ShellAlbert/PoF_TMR/NewVersion_3Sensors_TempPowerMonitor/Schematic/PSU.png

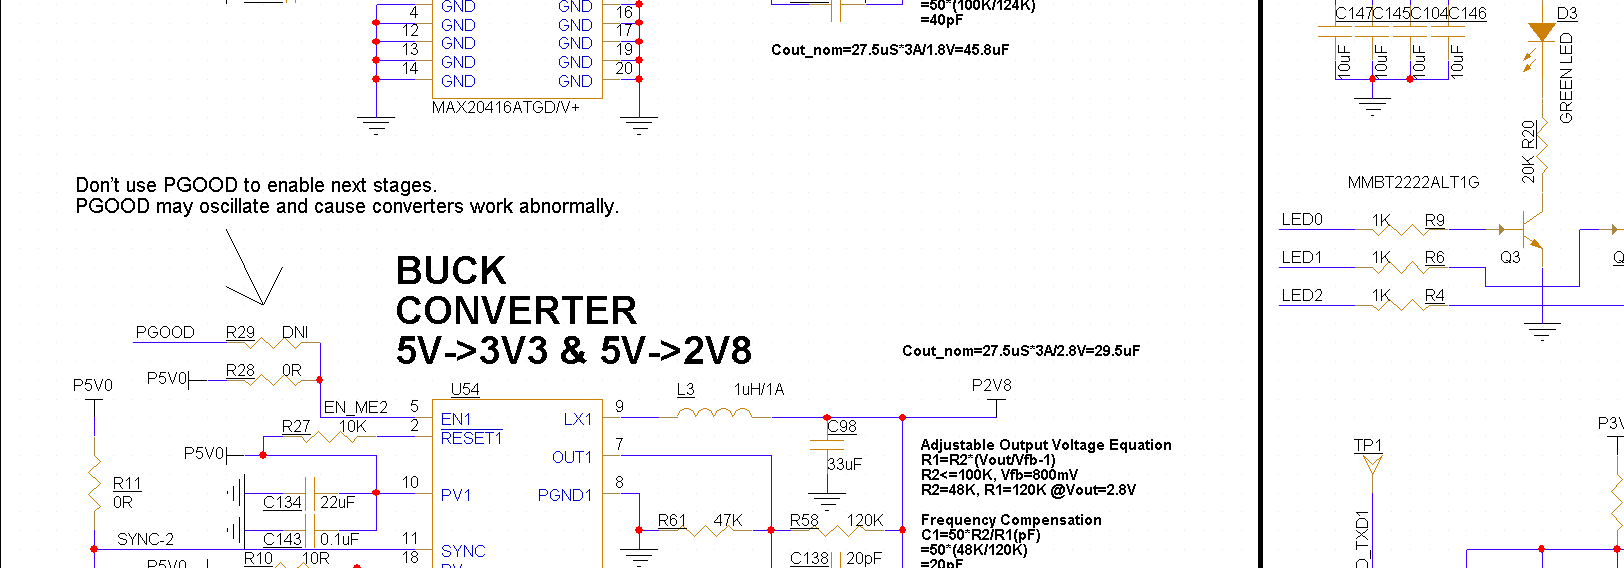
NewVersion_3Sensors_TempPowerMonitor/Schematic/PSU.png
