ShellAlbert/PoF_TMR/NewVersion_3Sensors_TempPowerMonitor/WangZhiiLiang_Handover/377886659.jpg

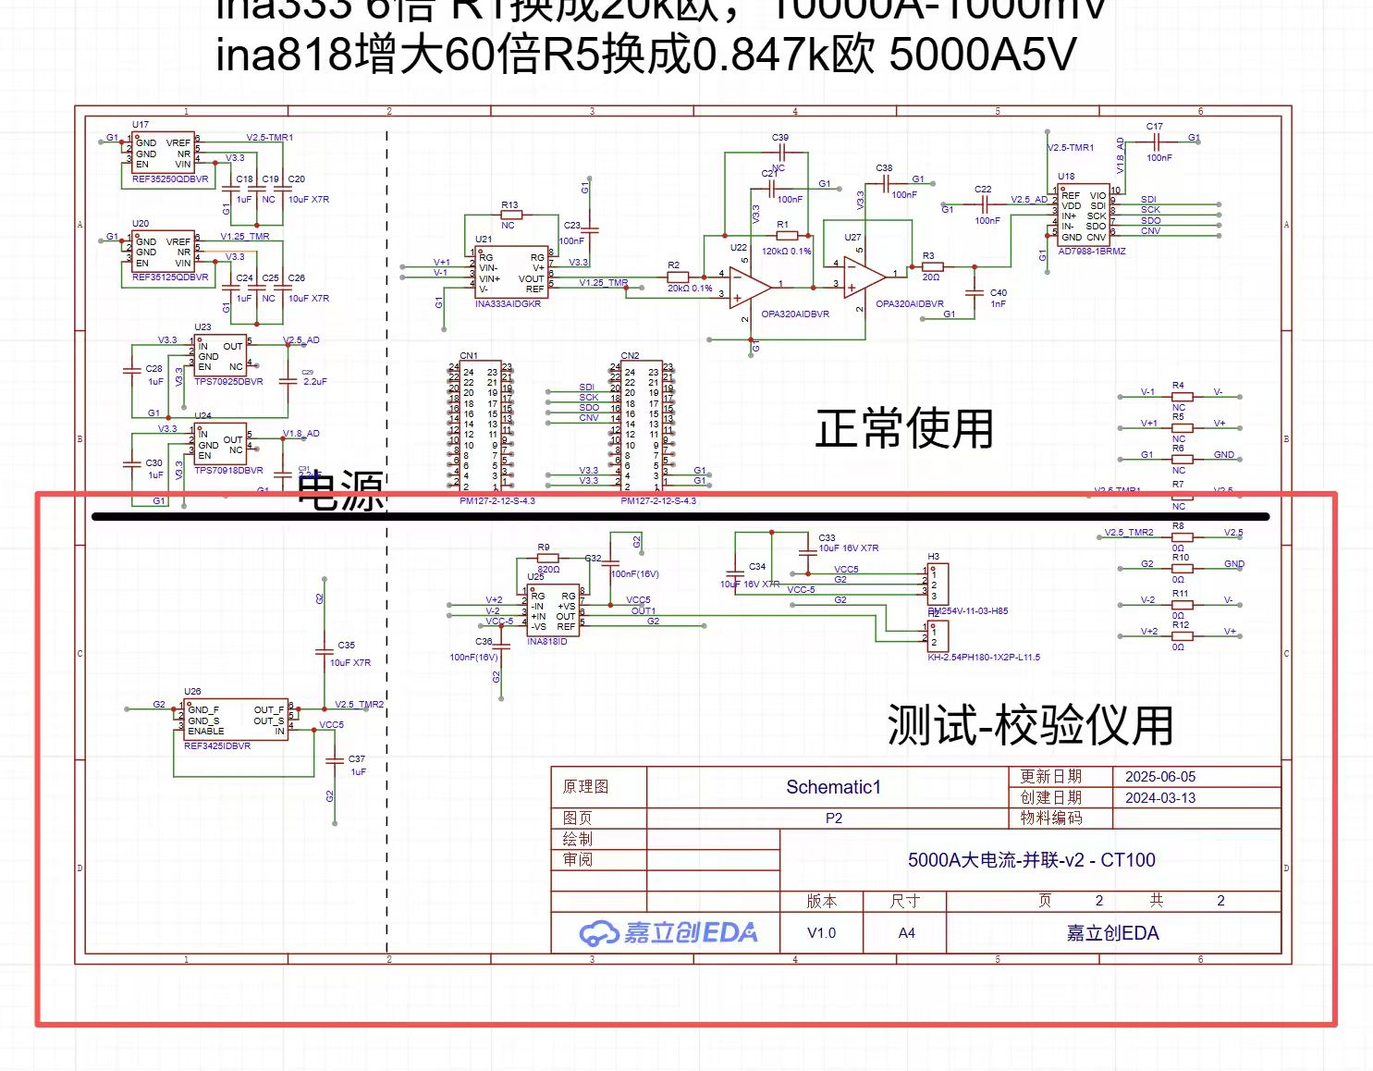
NewVersion_3Sensors_TempPowerMonitor/WangZhiiLiang_Handover/377886659.jpg
