ShellAlbert/PoF_TMR/Separated_Version_No_PowerMonitor/Fabrication/BOM_JLC_Matched.xls

型号 | 封装 | 位号 | 元件编号
22nF | C0402_SMT | C13,C15 | C1532
510 | R0402_SMT | R33 | C25123
20R | R0402_SMT | R72,R73 | C25089
CONN-1X8 | FPC-0D5-8P | J1,J4 | C262657
iCE40UP5K-SG48 | QFN-48 | U5 | C2678152
12.0MHz | SMD2520-4P | Y1 | C669073
125K | R0402_SMT | R56 | C36777
MAX20416ATGD/V+ | TQFN-24 | U3,U4 | C3188775
10uF | C0402_SMT | C1,C9,C11,C34,C37,C39,C41,C46,C49,C50,C51,C52,C53,C54,C55,C56 | C15525
HFBR-1414TZ-TX | HFBR-1414TZ-TX | D4,D5 | C33189
LTC3129EUD | QFN-16 | U6 | C580698
20K | R0402_SMT | R8,R11,R17 | C25765
47uF | C1206_SMT | C7,C8,C10,C14,C17,C19 | C403725
1N5819WT | SOD-523 | D6 | C5185918
120K | R0402_SMT | R57 | C25750
10R | R0402_SMT | R2,R4 | C25077
10nF | C0402_SMT | C47 | C15195
470K | R0402_SMT | R37,R45 | C25790
1uH/1A | L1210 | L1,L2,L3,L4 | C237284
100R | R0402_SMT | R64 | C25076
1M | R0402_SMT | R46 | C26083
T2N7002BK | SOT23-3 | Q7,Q9 | C146372
100pF | C0402_SMT | C25 | C1546
432K | R0402_SMT | R47 | C11562
2.2uF | C0402_SMT | C18 | C12530
6.8K | R0402_SMT | R13,R14,R16 | C25917
2.2K | R0402_SMT | R59 | C25879
16pF | C0402_SMT | C28 | C77590
2.2uH | L0402 | L6 | C383389
100K | R0402_SMT | R35,R49,R50 | C25741
20pF | C0402_SMT | C27 | C1554
154K | R0402_SMT | R58 | C26993
4.7uH/1A | IND_SMD_4D4X4D2 | L5 | C5349668
143K | R0402_SMT | R40 | C48391441
142K | R0402_SMT | R43 | C48391441
0R | R0402_SMT | R5,R10,R23,R32,R34,R36,R38,R41,R53,R62,R63,R66 | C17168
BFR93AWH6327 | SOT23-3 | Q1,Q2,Q6,Q8 | C3027191
1uF | C0402_SMT | C2,C3 | C52923
10uF | C0603_SMT | C33 | C19702
MMBT2222ALT1G | SOT-23-3 | Q3,Q4,Q5 | C82460
33uF | C1206_SMT | C5,C6 | C342307
0.47uF | C0402_SMT | C43 | C47339
4.7K | R0402_SMT | R48,R54 | C25900
33R | R0402_SMT | R42 | C25105
10K | R0402_SMT | R1,R12,R15,R24,R25,R27,R28,R65,R68,R71,R74,R75 | C25744
TMP117 | WDFN-6-EP-2x2 | U1 | C699536
SWKEY-SPST | SW_SMD_2P_L3D9_W3D0_P4D5 | SW1 | C36936655
39pF | C0402_SMT | C26 | C1563
33pF | C0402_SMT | C12 | C1562
1K | R0402_SMT | R7,R9,R20 | C11702
GREENLED | LED0402_SMT | D1,D2,D3 | C130723
W25Q64JWSSIQ | SOIC-8 | U7 | C2985658
BLM15PX121SN1D | L0402_SMT | FB1,FB2 | C88970
0.1uF | C0402_SMT | C4,C16,C20,C29,C30,C31,C32,C35,C36,C38,C40,C42,C44,C45,C48 | C1525
CONN-24P | SMD_CONN_2X12P_1D27 | J2,J3 | C2881917
48K | R0402_SMT | R51 | C25897
49.9K | R0402_SMT | R52,R55 | C25897
22uF | C0603_SMT | C21,C22,C23,C24 | C84419
APS25608N-OBR-BD | BGA-24 | U2 | NC
DNP | R0402_SMT | R3,R6,R39 | NC
DNI | R0402_SMT | R18,R19,R21,R22,R26,R29,R30,R31,R44,R60,R61,R67,R69,R70 | NC
