ShellAlbert/PoF_TMR/NewVersion_3Sensors_TempPowerMonitor/Schematic/PSU1W_Debug.png

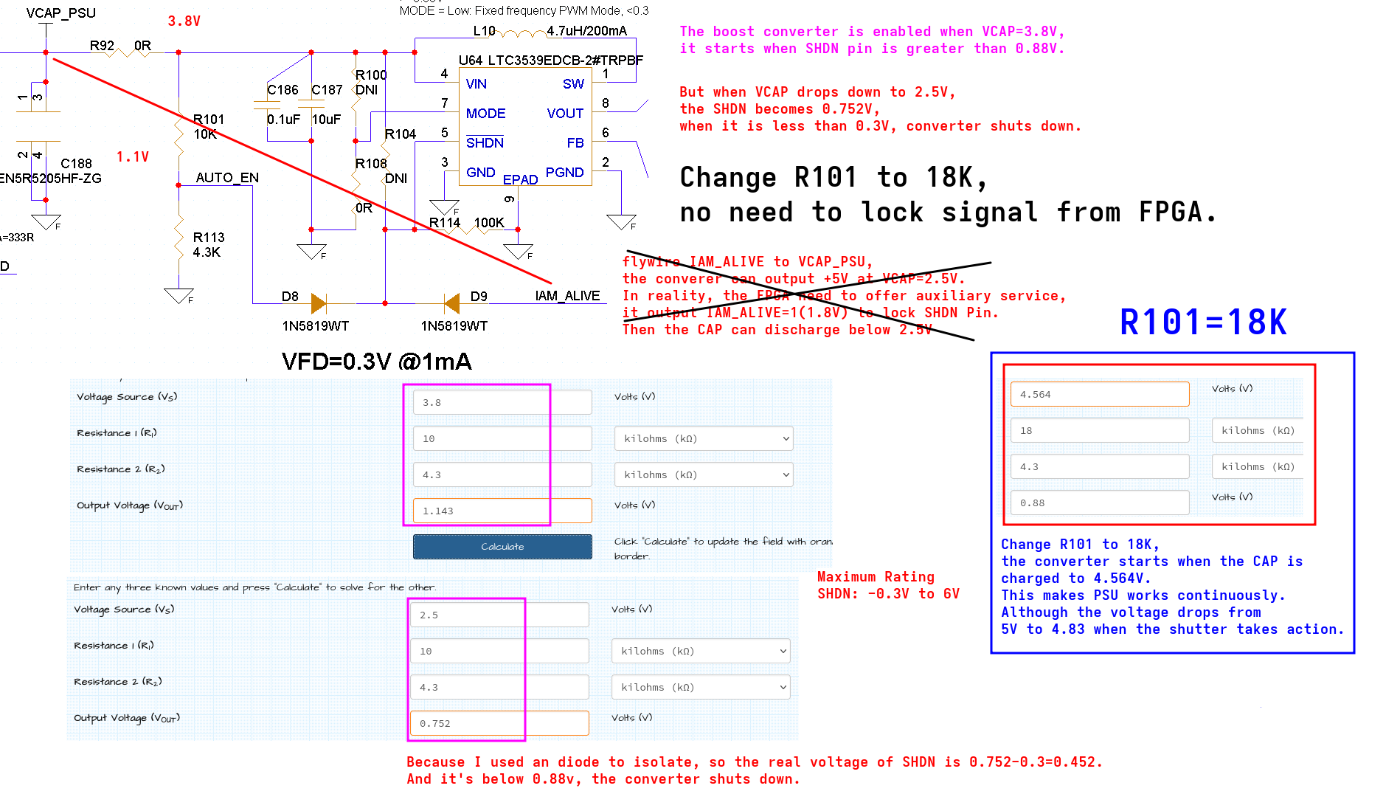
NewVersion_3Sensors_TempPowerMonitor/Schematic/PSU1W_Debug.png
