ShellAlbert/PoF_TMR/NewVersion_3Sensors_TempPowerMonitor/Schematic/2-FPGA.pdf

# VIN:

5V~7V

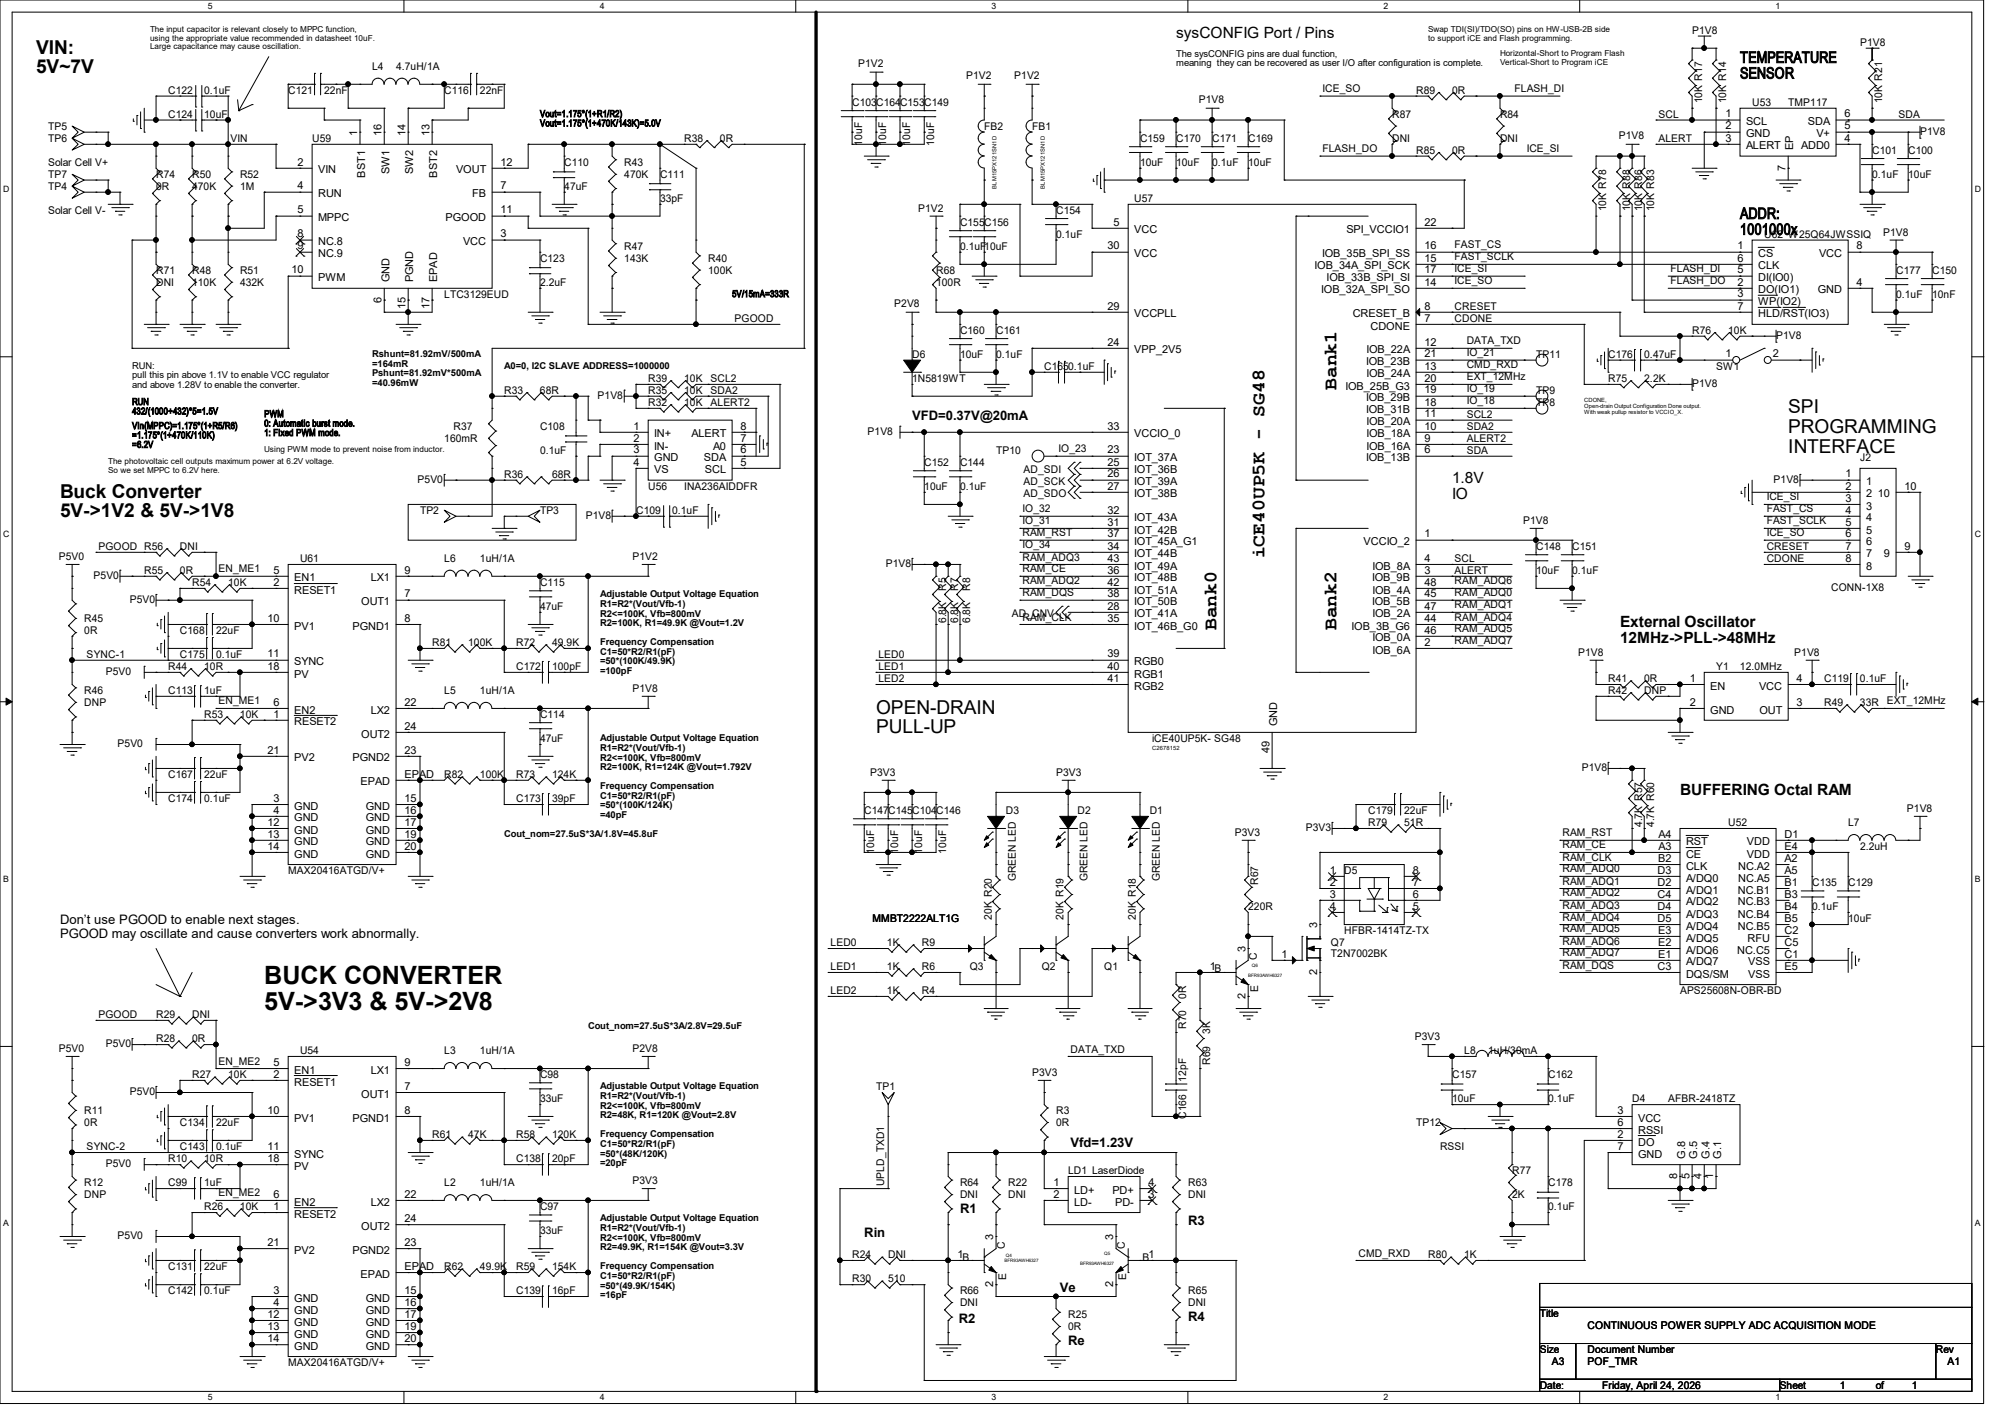
[picture p6: page 1]

The input capacitor is relevant closely to MPPC function, using the appropriate value recommended in datasheet 10uF. Large capacitance may cause oscillation. L4 4.7uH/1A | sysCONFIG Port / Pins Swap TDI(SI)/TDO(SO) pins on HW-USB-2B side P1V2 meaning they can be recovered as user I/O after configuration is complete.

The sysCONFIG pins are dual function,

to support iCE and Flash programming.

Horizontal-Short to Program Flash
Vertical-Short to Program iCE

6 FB 7 NC.8 8 NC.9 9 PWM 10 PGOOD 11 VOUT 12 BST2 13 SW2 14 PGND 15 SW1 16 EPAD 17

1 VIN 2 VCC 3 RUN 4 MPPC 5 GND

RUN:
pull this pin above 1.1V to enable VCC regulator
and above 1.28V to enable the converter.
RUN

CDONE,
Open-drain Output Configuration Done output.

Using PWM mode to prevent noise from inductor.

The photovoltaic cell outputs maximum power at 6.2V voltage.
So we set MPPC to 6.2V here.
Buck Converter

Don’t use PGOOD to enable next stages.
PGOOD may oscillate and cause converters work abnormally.
