ShellAlbert/PoF_TMR/NewVersion_3Sensors_TempPowerMonitor/Schematic/1-ADC.pdf

# TMR SENSOR X16 CONNECTED IN PARALLEL

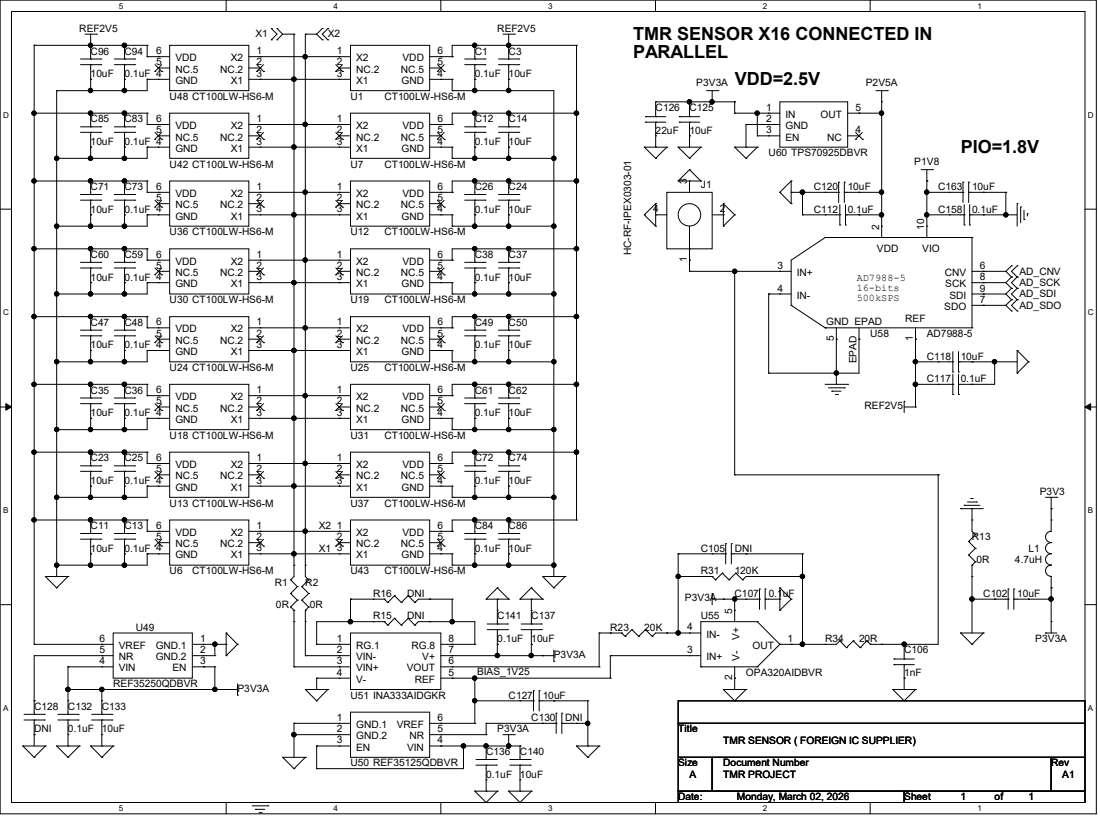
[picture p7: page 1]

J1 HC⁻RF⁻IPEX⁰³⁰³⁻⁰¹

EN 3 VIN 4 NR 5 VREF 6

TMR SENSOR ( FOREIGN IC SUPPLIER)
