ShellAlbert/PoF_TMR/NewVersion_3Sensors_TempPowerMonitor/Schematic/3-Hirose70239.pdf

## Yantai InfiRay Lite640x512 Infrared Image Sensor

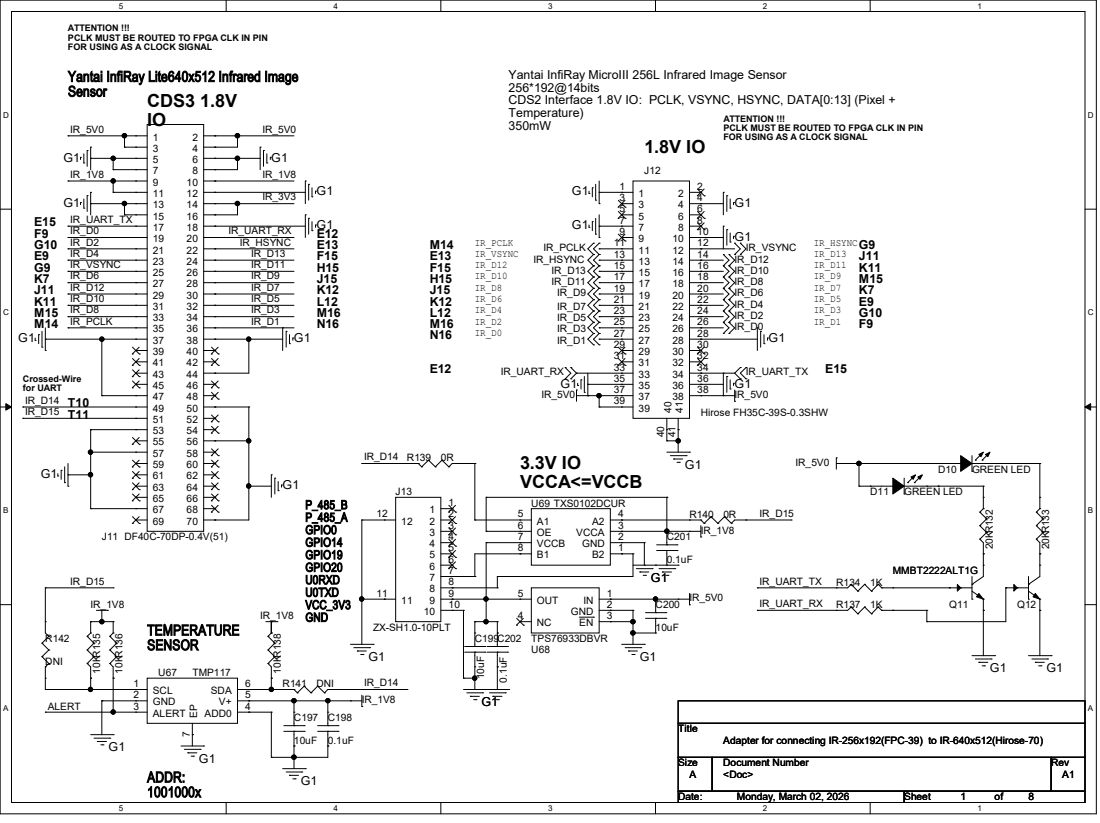
[picture p8: page 1]

ATTENTION !!!
PCLK MUST BE ROUTED TO FPGA CLK IN PIN
FOR USING AS A CLOCK SIGNAL

Yantai InfiRay MicroIII 256L Infrared Image Sensor
256*192@14bits
CDS2 Interface 1.8V IO: PCLK, VSYNC, HSYNC, DATA[0:13] (Pixel +
Temperature)

Adapter for connecting IR-256x192(FPC-39) to IR-640x512(Hirose-70)
