ShellAlbert/PoF_TMR/NewVersion_3Sensors_TempPowerMonitor/Schematic/5-PSU1W.pdf

# VIN:

5V~7V

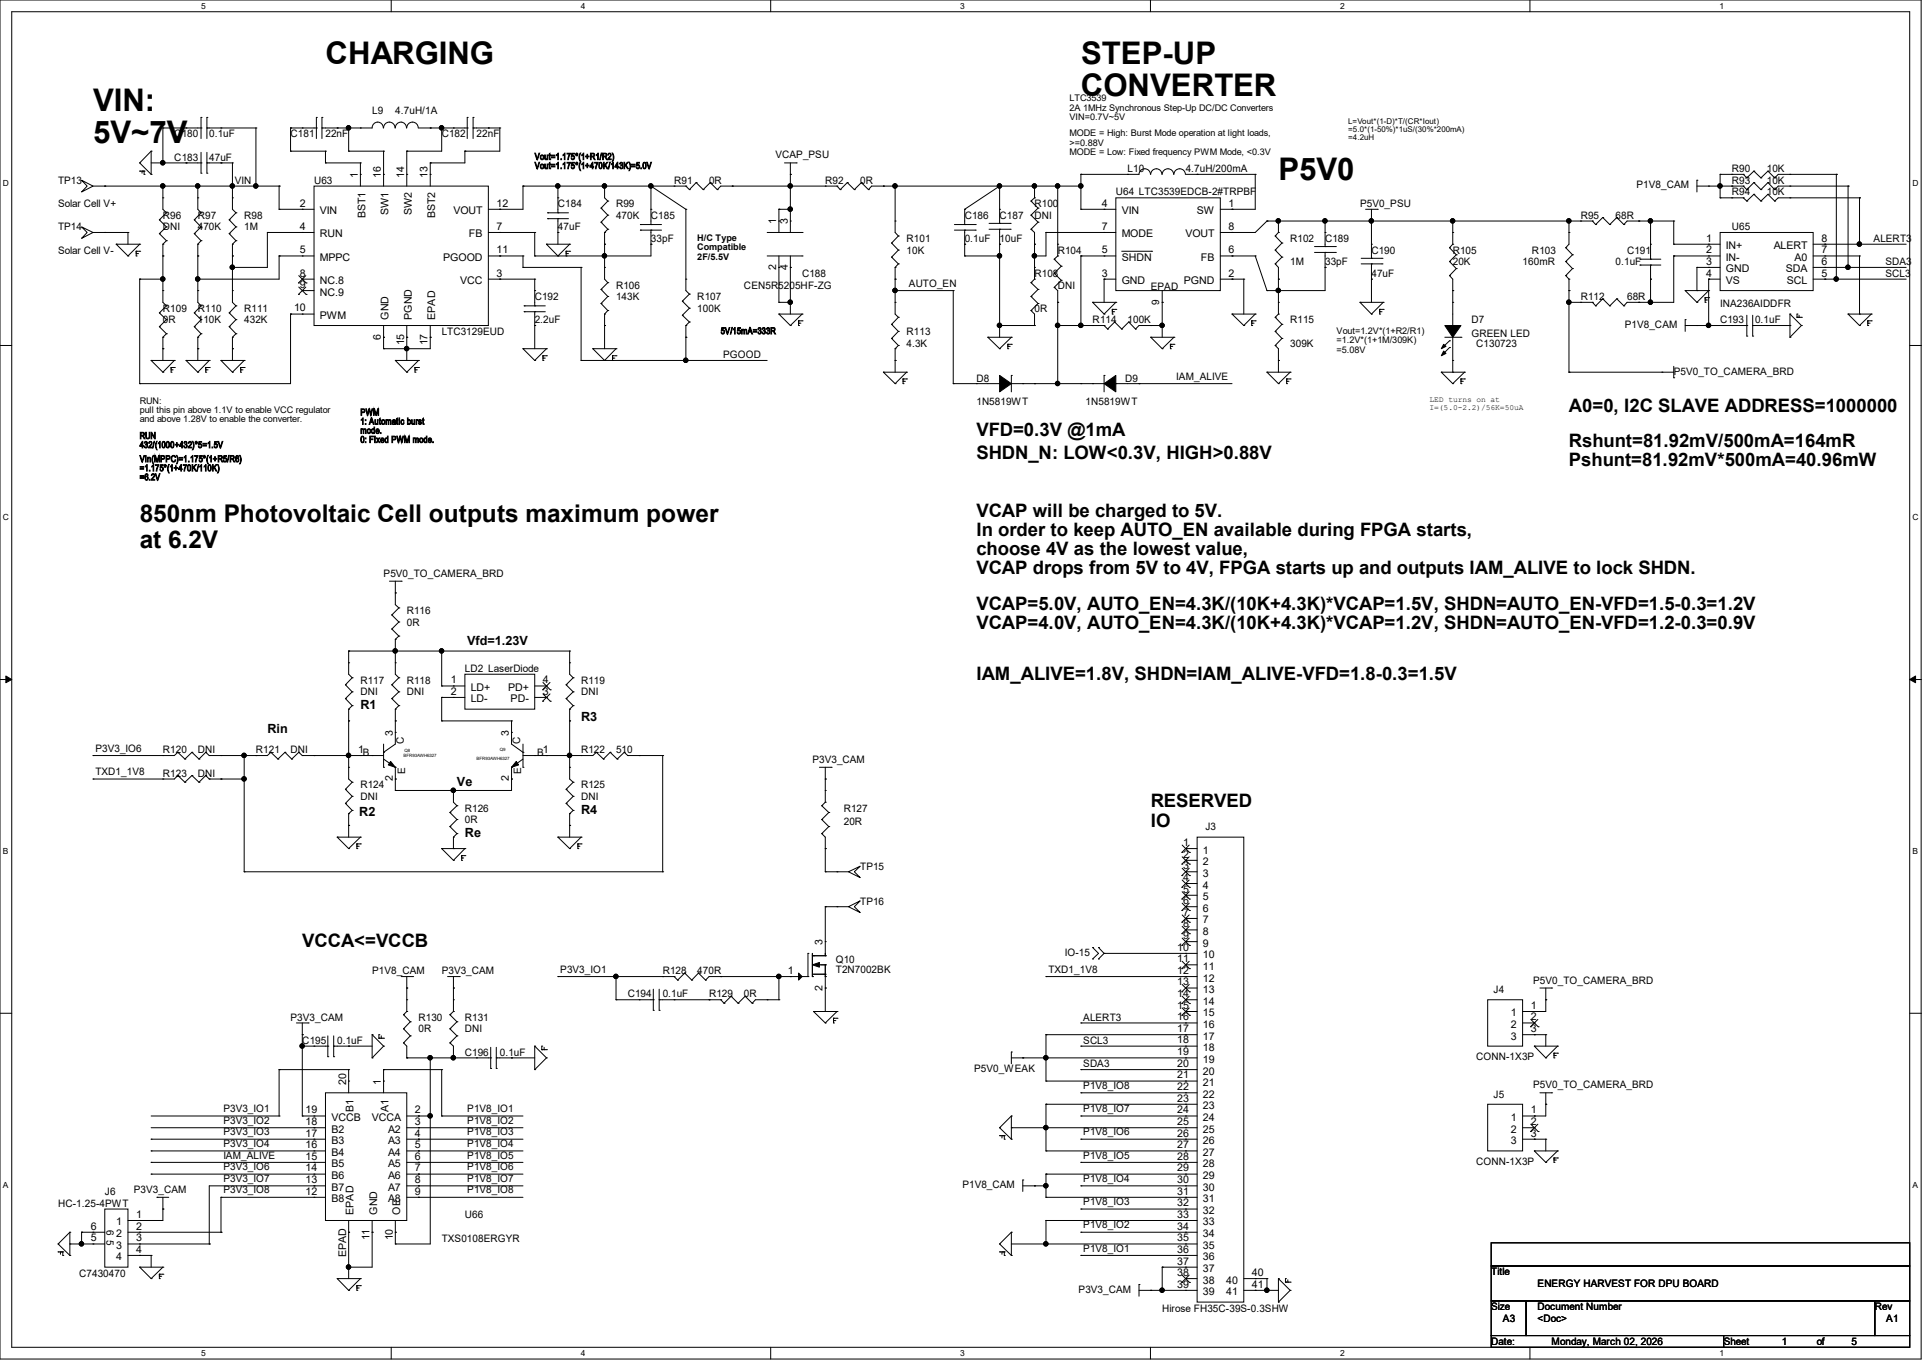
[picture p9: page 1]

LTC3539
2A 1MHz Synchronous Step-Up DC/DC Converters
VIN=0.7V~5V
=4.2uH MODE = High: Burst Mode operation at light loads,
MODE = Low: Fixed frequency PWM Mode, <0.3V

6 FB 7 NC.8 8 NC.9 9 PWM 10 PGOOD 11 VOUT 12 BST2 13 SW2 14 PGND 15 SW1 16 EPAD 17 C183 47uF

1 VIN 2 VCC 3 RUN 4 MPPC 5 GND

RUN:
pull this pin above 1.1V to enable VCC regulator
and above 1.28V to enable the converter.
RUN
Vin(MPPC)=1.175*(1+R5/R6)
850nm Photovoltaic Cell outputs maximum power

LED turns on at

VCAP will be charged to 5V.
In order to keep AUTO_EN available during FPGA starts,
choose 4V as the lowest value,
VCAP drops from 5V to 4V, FPGA starts up and outputs IAM_ALIVE to lock SHDN.
VCAP=5.0V, AUTO_EN=4.3K/(10K+4.3K)*VCAP=1.5V, SHDN=AUTO_EN-VFD=1.5-0.3=1.2V
VCAP=4.0V, AUTO_EN=4.3K/(10K+4.3K)*VCAP=1.2V, SHDN=AUTO_EN-VFD=1.2-0.3=0.9V

1 B1 20 OE 10 GND 11 B8 12 B7 13 B6 14 B5 15 B4 16 B3 17 B2 18 VCCB 19 EPAD EPAD
