ShellAlbert/PoF_TMR/Separated_Version_No_PowerMonitor/Schematic/SCH_POF_TMR_A1.pdf

VIN: 5V~7V | sysCONFIG Port / Pins P1V2
The sysCONFIG pins are dual function,

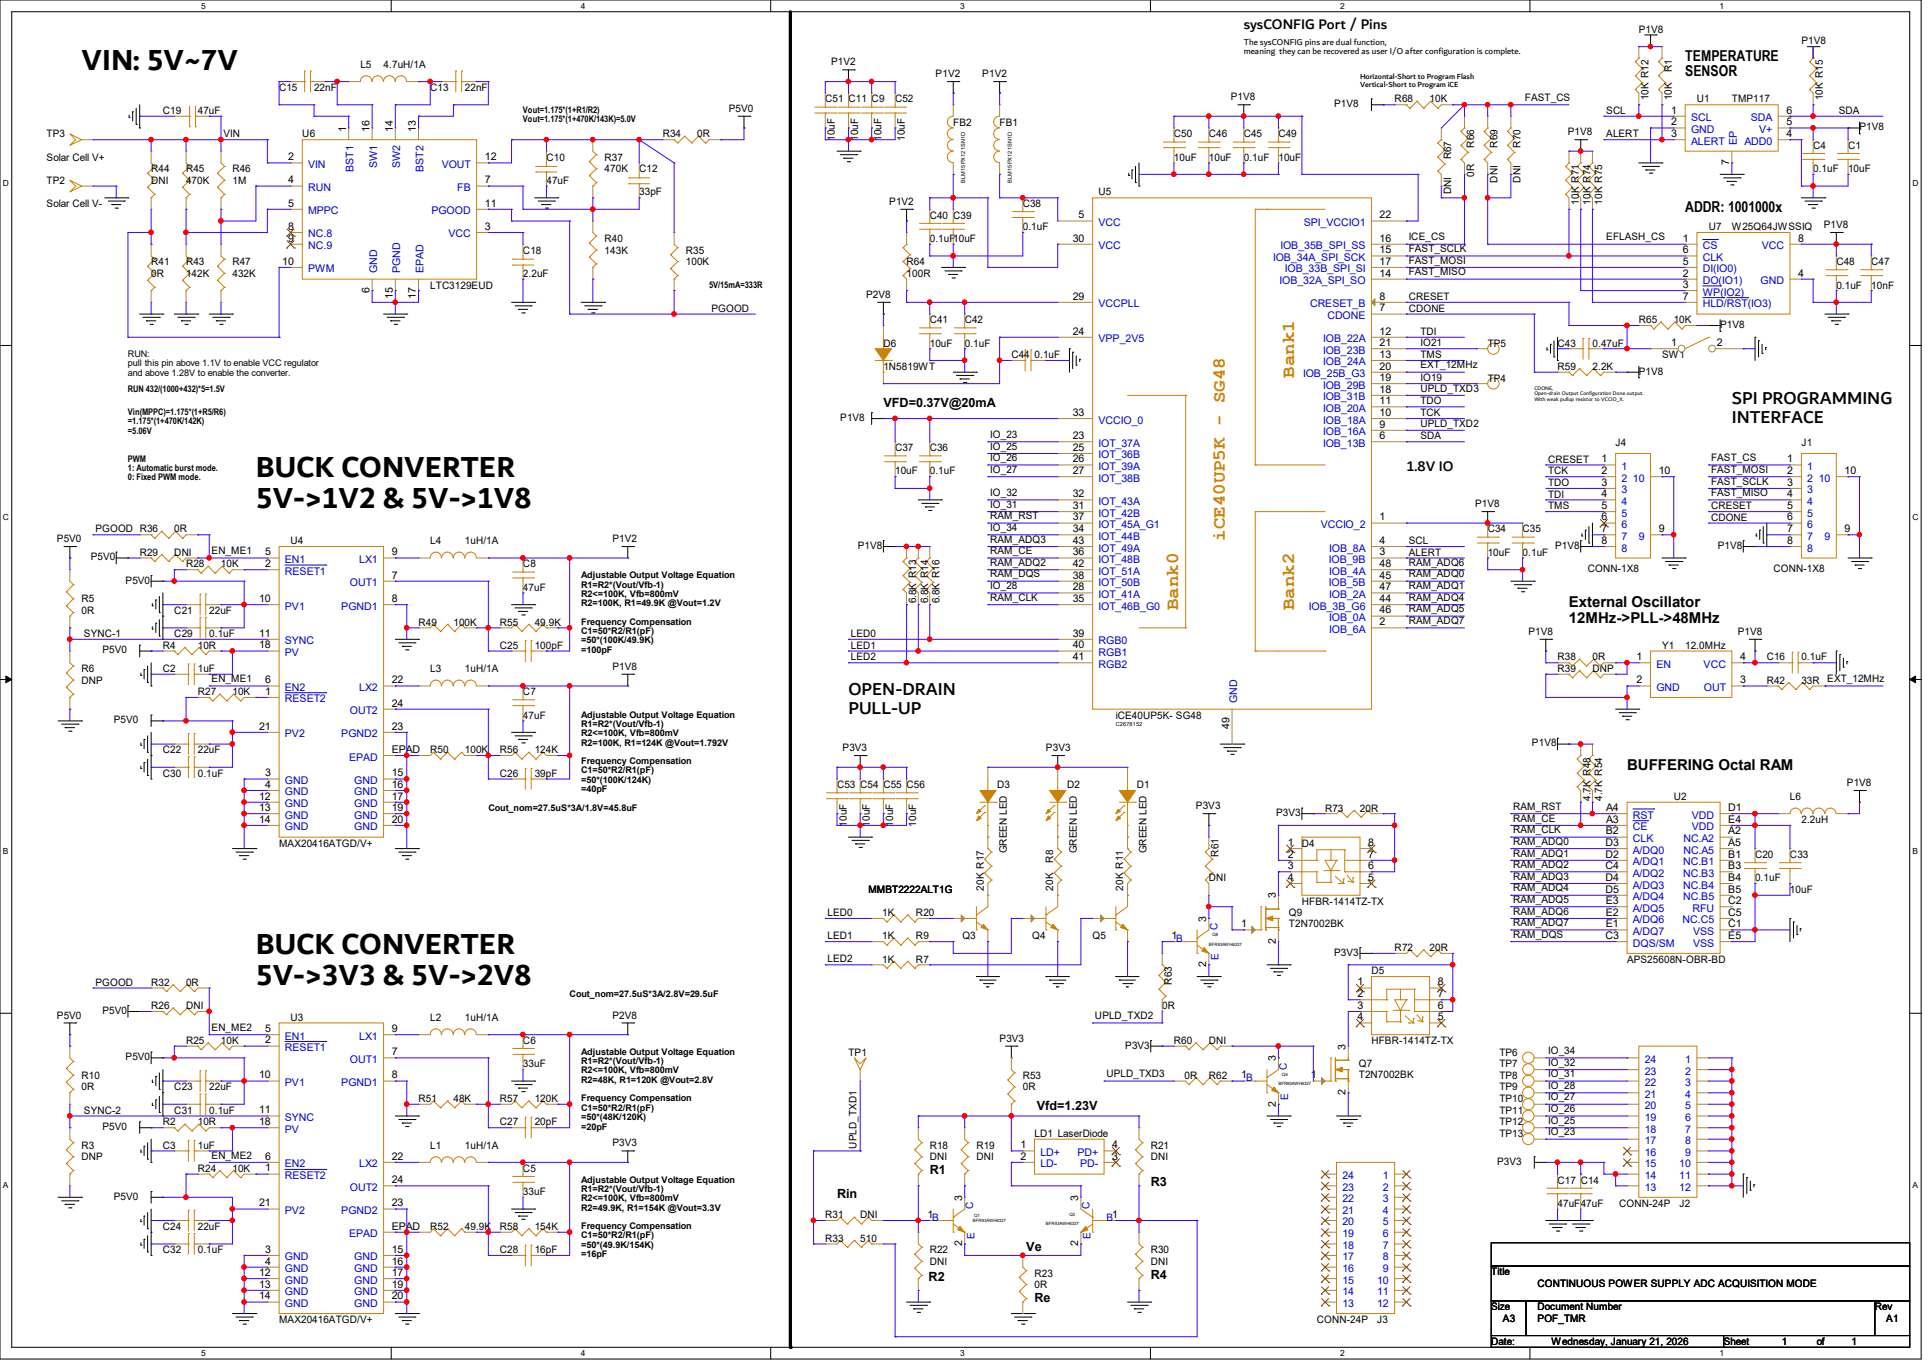
[picture p10: page 1]

meaning they can be recovered as user I/O after configuration is complete.

Horizontal-Short to Program Flash
Vertical-Short to Program iCE

6 FB 7 NC.8 8 NC.9 9 PWM 10 PGOOD 11 VOUT 12 BST2 13 SW2 14 PGND 15 SW1 16 EPAD 17 C6

1 VIN 2 VCC 3 RUN 4 MPPC 5 GND

RUN:
pull this pin above 1.1V to enable VCC regulator
and above 1.28V to enable the converter.
RUN 432/(1000+432)*5=1.5V
BUCK CONVERTER
