ShellAlbert/PoF_TMR/NewVersion_3Sensors_TempPowerMonitor/Schematic/4-Magic2956.pdf

# REF2V5 REF2V5 REF2V5 REF2V5 REF2V5 REF2V5 REF2V5 REF2V5

# REF2V5 REF2V5 REF2V5 REF2V5 REF2V5 REF2V5 REF2V5 REF2V5

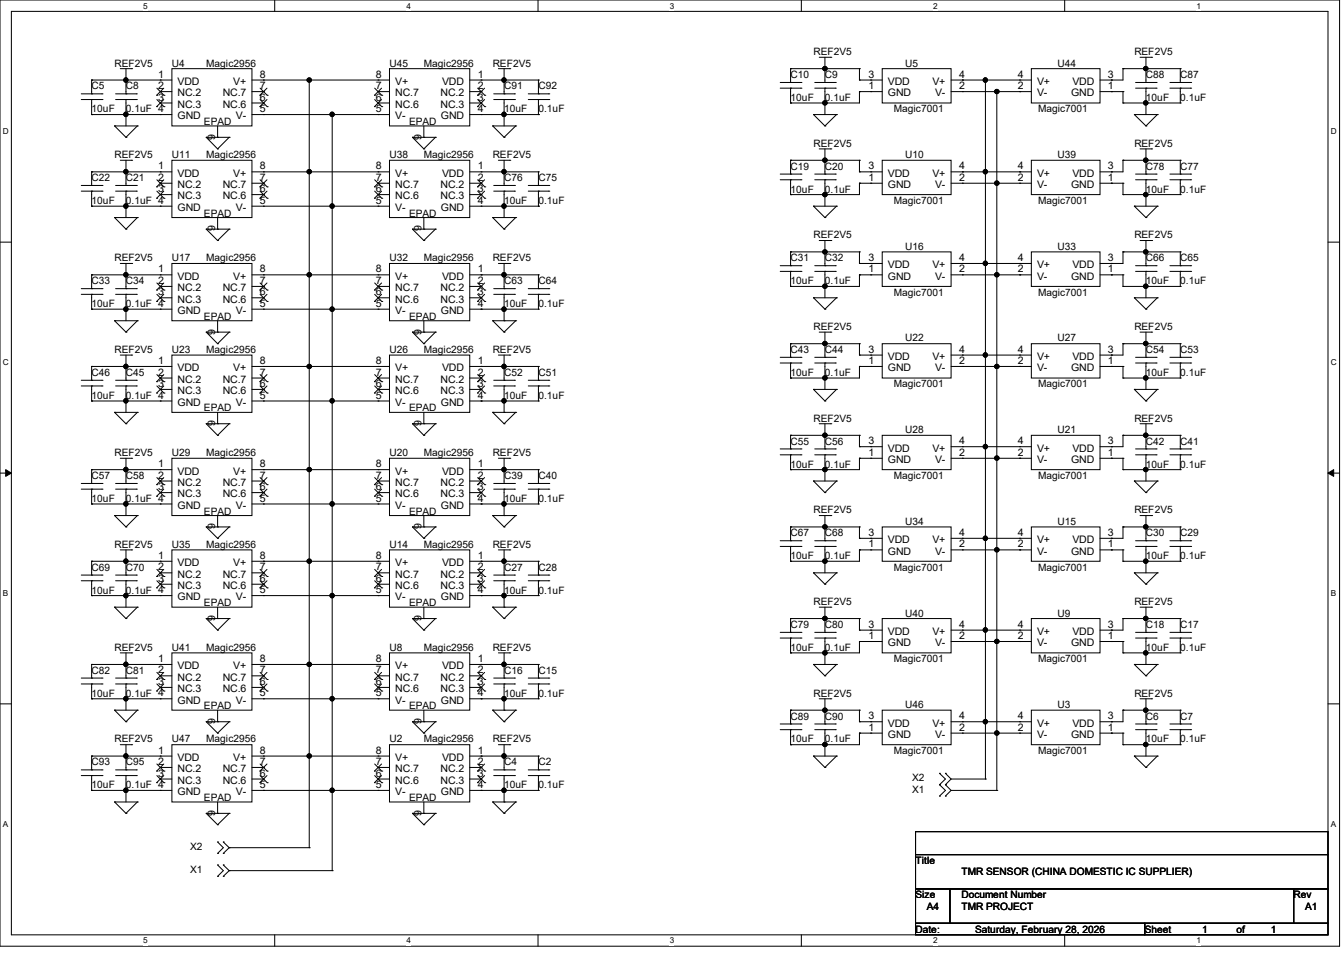
[picture p11: page 1]
