ShellAlbert/PoF_TMR/(list of files, drawings)

Other design files:
NewVersion_3Sensors_TempPowerMonitor/Schematic/LIBRARY1.OLB
NewVersion_3Sensors_TempPowerMonitor/Schematic/PSU.DSN
NewVersion_3Sensors_TempPowerMonitor/Schematic/PSU.opj
NewVersion_3Sensors_TempPowerMonitor/WangZhiiLiang_Handover/5000A大电流-加法-v2+-+CT100.eprj
Separated_Version_No_PowerMonitor/Schematic/LIBRARY1.OLB
Separated_Version_No_PowerMonitor/Schematic/PSU.DSN
Separated_Version_No_PowerMonitor/Schematic/PSU.opj
