ShellAlbert/PoF_TMR/NewVersion_3Sensors_TempPowerMonitor/Radiant/PoF_TMR/source/impl_1/ZAD7988_Adapter.v

module ZAD7988_Adapter(
    //common signals.
	input wire iClk, //input clock.
	input wire iRstN,
	input wire iEn,

	//AD7988 SPI-Compatible Interface.
	output wire oSDI,
	output wire oCNV,
	output wire oSCK,
	input wire iSDO, 

    //100KHz Tick. Used to measured by an oscilloscope.
    output reg o100KHz_Tick,

    //Write Data Into FIFO.
    input wire iFIFOFullFlag,
    output reg oFIFOWrEn,
    output reg[15:0] oFIFODataIn,

    //Working LED indicator.
    output reg oLED
);

/////////////////////////////////////////////////
reg adc_en;
wire adc_valid;
wire [15:0] adc_data;
ZAD7988_Controller u1_ad7988(
	//common signals.
	.iClk(iClk), //input clock.
	.iRstN(iRstN),
	.iEn(adc_en),

	//AD7988 SPI-Compatible Interface.
	.oSDI(oSDI),
	.oCNV(oCNV),
	.oSCK(oSCK),
	.iSDO(iSDO), 

	//acquisition data output interface.
	.oData(adc_data),
	.oDataValid(adc_valid)
);

//AD7988-1. Maximum Throughput Rate:100KHz.
//48MHz/100KHz/2=240.
reg [15:0] cnt_100KHz;
always @(posedge iClk or negedge iRstN) 
if(!iRstN) begin
    cnt_100KHz<=0; o100KHz_Tick<=0; 
end
else begin
    cnt_100KHz<=(iEn)?((cnt_100KHz==240-1)?(0):(cnt_100KHz+1)):(0);
    o100KHz_Tick<=(iEn)?((cnt_100KHz==240-1)?(~o100KHz_Tick):(o100KHz_Tick)):(0);
end
wire tick_100KHz;
assign tick_100KHz=(cnt_100KHz==240-1)?(1):(0);

/////////////////////////////////////////////////
//Driven by step_i.
reg [7:0] step_i;
reg [15:0] cnt_test;
reg [15:0] cnt_led; //LED flashes at 100KHz/2.
always @(posedge iClk or negedge iRstN)
if(!iRstN) begin 
    step_i<=0; adc_en<=0; oFIFOWrEn<=0; oFIFODataIn<=0; cnt_test<=0; cnt_led<=0; oLED<=0; 
end
else begin
    if(iEn) begin
        case(step_i)
        0: //100KHz Trigger.
            if(tick_100KHz) begin cnt_test<=cnt_test+1; step_i<=step_i+1; end
        1: //Read ADC Data.
            //if(adc_valid) begin adc_en<=0; oFIFODataIn<=cnt_test/*adc_data*/; step_i<=step_i+1; end
            if(adc_valid) begin adc_en<=0; oFIFODataIn<=adc_data; step_i<=step_i+1; end
            else begin adc_en<=1; end
        2: //Write Data into FIFO if FIFO is not full.
            //if(!iFIFOFullFlag) begin oFIFOWrEn<=1; step_i<=step_i+1; end
            //Don't judge whether the FIFO is full to check the data loss.
            //Reader is faster than Writer, so the FIFO will never be full.
            //Using an increased numbers to check whether the FIFO loses data.
            begin oFIFOWrEn<=1; step_i<=step_i+1; end
        3:
            begin 
                oFIFOWrEn<=0; 
                cnt_led<=(cnt_led==50_000-1)?(0):(cnt_led+1);
                oLED<=(cnt_led==50_000-1)?(~oLED):(oLED);
                step_i<=0;
            end
        endcase
    end
    else begin
        step_i<=0; adc_en<=0; oFIFOWrEn<=0; oFIFODataIn<=0; 
    end
end
/////////////////////////////////////////////////////////////////////////
endmodule
