ShellAlbert/PoF_TMR/NewVersion_3Sensors_TempPowerMonitor/Radiant/PoF_TMR/source/impl_1/ZUART_Tx.v

`timescale 1ns/1ps

module ZUART_Tx
#(parameter Freq_divider=416)
(
	input iClk,
	input iRst_N,
	input [7:0] iData,
	
	//pull down iEn to start transmition until pulse done oDone was issued.
	input iEn,
	output reg oDone,
	output reg oTxD
);

//generate 1MHz Clock. //48MHz/1MHz=48.
//generate 2MHz Clock. //48MHz/2M=24.
//generate 4MHz Clock, //48MHz/4MHz=12.
//generate 115200bps, 48MHz/115200bps=416.7

//We expect a 100MHz PLL output, but the report gives out the maximum frequency is 51MHz.
//Single Clock Domain
//-------------------------------------------------------------------------------------------------------
//	Clock clk_100MHz            |                    |       Period       |     Frequency      
//-------------------------------------------------------------------------------------------------------
//	 From clk_100MHz                        |             Target |          10.000 ns |        100.002 MHz 
//											| Actual (all paths) |          19.442 ns |         51.435 MHz 
//100MHz/2MHz=5.
//51.435MHz/2MHz=25.7175
reg [15:0] CNT1;
always @(posedge iClk or negedge iRst_N)
if(!iRst_N) begin
	CNT1<=0;
end
else if(iEn) begin 
				if(CNT1==Freq_divider-1) begin CNT1<=0; end
				else begin CNT1<=CNT1+1; end
			end
	else begin CNT1<=0;	end

wire tx_clk;
assign tx_clk=(CNT1==Freq_divider-1)?1:0;

//Tx: start bit(1)+data bits(8)+stop bit(1)
//Tx Idle is High.
//Pull Low to start transfer, start bit is Low.
//8 bits data.
//1 Stop bit is High.
reg [7:0] CNT2;
reg [8:0] CNT_Shift;
always @(posedge iClk or negedge iRst_N)
if(!iRst_N) begin
	oTxD<=1; //Idle is Zero.
	oDone<=0; CNT2<=0; CNT_Shift<=0;
end
else if(iEn) begin
				case(CNT2)
					0: //start bit(1).
						if(tx_clk) begin oTxD<=0; CNT2<=CNT2+1; end
					1: //data bits(8).
						if(tx_clk) begin 
							//oTxD<=iData[7-CNT_Shift]; //MSB first.
							//oTxD<=iData[CNT_Shift]; //LSB first.
							//oTxD<=~iData[CNT_Shift]; //LSB first.
							oTxD<=iData[CNT_Shift]; //LSB first.
							CNT2<=CNT2+1; 				
						end
					2: 
						if(CNT_Shift==7) begin CNT_Shift<=0; CNT2<=CNT2+1; end
						else begin CNT_Shift<=CNT_Shift+1; CNT2<=CNT2-1; end
					3: //stop bit(1).
						if(tx_clk) begin oTxD<=1; CNT2<=CNT2+1; end
					4:	//gap between two transfer.
						if(tx_clk) begin CNT2<=CNT2+1; end
					5: //done signal.
						begin oDone<=1; CNT2<=CNT2+1; end
					6: //done signal.
						begin oDone<=0; CNT2<=0; end
					default:
						begin oTxD<=1; oDone<=0; CNT2<=0; end
				endcase
			end
	else begin
			oTxD<=1; oDone<=0; CNT2<=0;
		end
endmodule
