ShellAlbert/PoF_TMR/(commit log)

2026-01-21 Initial Version
    [BOM_PoF_TMR_A1.xlsx, LIBRARY1.OLB, PSU.DSN, PSU.opj, PickAndPlace_PoF_TMR_A1.xlsx, cases.cfg]
2026-01-21 Update Footprints
    [BOM_JLC_Matched.xls]
2026-03-03 NewTMR,3 Sensors+Temperature+Power Monitor IC
    [5000A大电流-加法-v2+-+CT100.eprj, BOM_JLC_Matched.xls, BOM_PoF_TMR_A1.xlsx, FPGA-SC-02006-0-92_LIFCL17_Pinout.csv, LIBRARY1.OLB, PSU.DSN, PSU.opj, PickAndPlace_PoF_TMR_A1.xlsx]
2026-04-24 Update TMR
    [PSU.DSN, PSU.opj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]
